volium/swarm/swarm.kicad_pcb

## KiCad design swarm.kicad_pcb (2017-08-13)

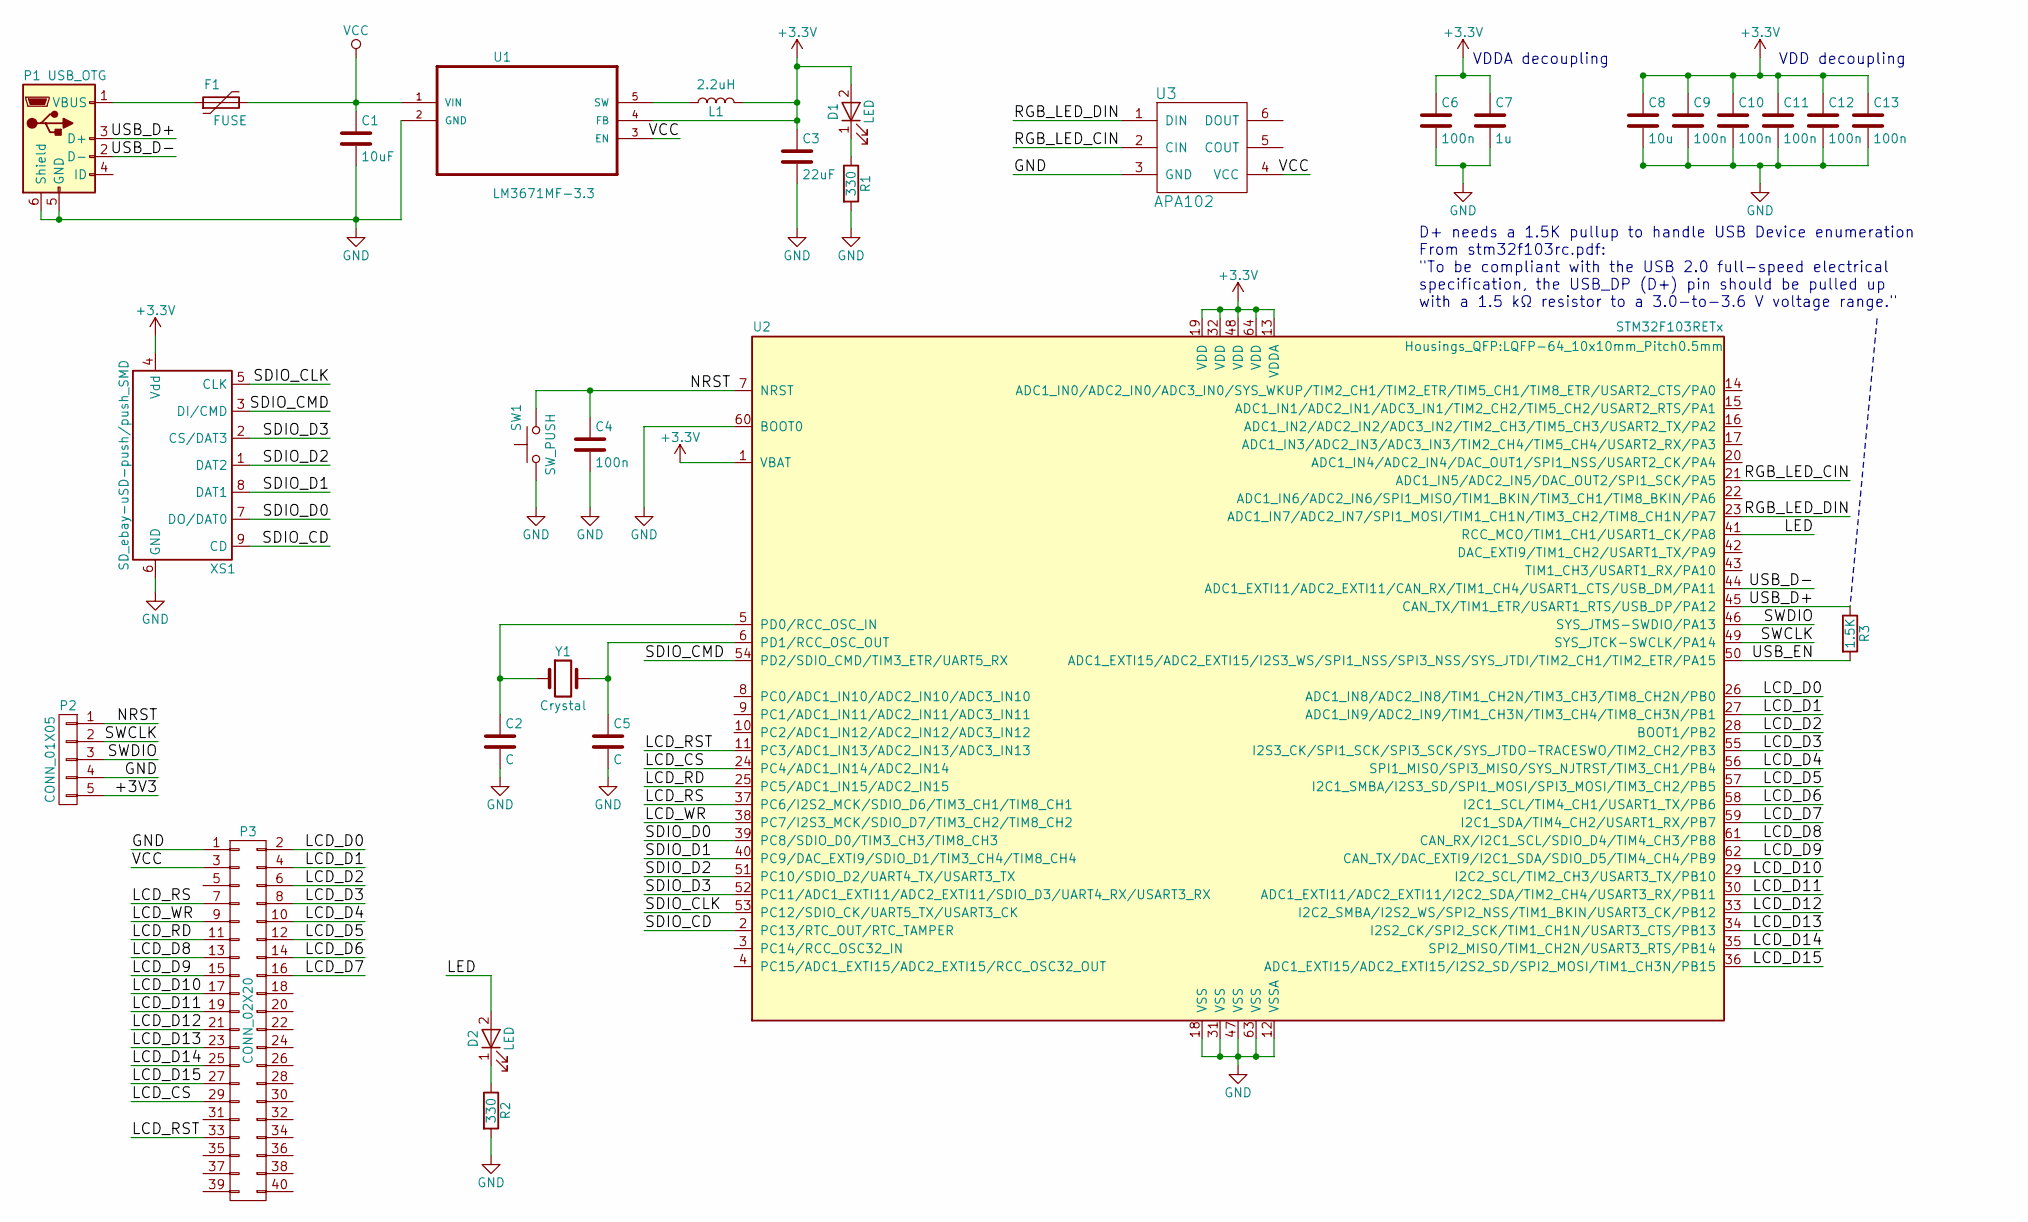
[picture p1: schematic swarm.sch]

Parts:
C1: 10uF; C_0805
C2, C5: C; C_0805
C3: 22uF; C_0805
C4, C6, C9, C10, C11, C12, C13: 100n; C_0805
C7: 1u; C_0805
C8: 10u; C_0805
D1, D2: LED; LED_0805
F1: FUSE; MF-PSMF050X
L1: 2.2uH; Inductor_Taiyo-Yuden_NR-24xx_HandSoldering
P1: USB_OTG; USB_Mini-B
P2: CONN_01X05; Pin_Header_Angled_1x05
P3: CONN_02X20; Pin_Header_Straight_2x20
R1, R2: 330; R_0805
R3: 1.5K; R_0805
SW1: SW_PUSH; SW_SPST_PTS645
U1: LM3671MF-3.3; SOT-23-5
U2: STM32F103RETx; LQFP-64_10x10mm_Pitch0.5mm
U3: APA102
XS1: SD_ebay-uSD-push/push_SMD; Conn_uSDcard
Y1: Crystal; Crystal_SMD_5032_2Pads

Connections:
/LCD_CS: P3.29, U2.24 (PC4/ADC1_IN14/ADC2_IN14)
/LCD_D0: P3.2, U2.26 (ADC1_IN8/ADC2_IN8/TIM1_CH2N/TIM3_CH3/TI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)
/LCD_D1: P3.4, U2.27 (ADC1_IN9/ADC2_IN9/TIM1_CH3N/TIM3_CH4/TI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)
/LCD_D2: P3.6, U2.28 (BOOT1/PB2)
/LCD_D3: P3.8, U2.55 (I2S3_CK/SPI1_SCK/SPI3_SCK/SYS_JTDO-TRAC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)
/LCD_D4: P3.10, U2.56 (SPI1_MISO/SPI3_MISO/SYS_NJTRST/TIM3_CH1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)
/LCD_D5: P3.12, U2.57 (I2C1_SMBA/I2S3_SD/SPI1_MOSI/SPI3_MOSI/T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)
/LCD_D6: P3.14, U2.58 (I2C1_SCL/TIM4_CH1/USART1_TX/PB6)
/LCD_D7: P3.16, U2.59 (I2C1_SDA/TIM4_CH2/USART1_RX/PB7)
/LCD_D8: P3.13, U2.61 (CAN_RX/I2C1_SCL/SDIO_D4/TIM4_CH3/PB8)
/LCD_D9: P3.15, U2.62 (CAN_TX/DAC_EXTI9/I2C1_SDA/SDIO_D5/TIM4_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)
/LCD_D10: P3.17, U2.29 (I2C2_SCL/TIM2_CH3/USART3_TX/PB10)
/LCD_D11: P3.19, U2.30 (ADC1_EXTI11/ADC2_EXTI11/I2C2_SDA/TIM2_C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)
/LCD_D12: P3.21, U2.33 (I2C2_SMBA/I2S2_WS/SPI2_NSS/TIM1_BKIN/US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)
/LCD_D13: P3.23, U2.34 (I2S2_CK/SPI2_SCK/TIM1_CH1N/USART3_CTS/P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)
/LCD_D14: P3.25, U2.35 (SPI2_MISO/TIM1_CH2N/USART3_RTS/PB14)
/LCD_D15: P3.27, U2.36 (ADC1_EXTI15/ADC2_EXTI15/I2S2_SD/SPI2_MO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)
/LCD_RD: P3.11, U2.25 (PC5/ADC1_IN15/ADC2_IN15)
/LCD_RS: P3.7, U2.37 (PC6/I2S2_MCK/SDIO_D6/TIM3_CH1/TIM8_CH1)
/LCD_RST: P3.33, U2.11 (PC3/ADC1_IN13/ADC2_IN13/ADC3_IN13)
/LCD_WR: P3.9, U2.38 (PC7/I2S3_MCK/SDIO_D7/TIM3_CH2/TIM8_CH2)
/LED: D2.2 (A), U2.41 (RCC_MCO/TIM1_CH1/USART1_CK/PA8)
/NRST: C4.1, P2.1, SW1.2, U2.7 (NRST)
/RGB_LED_CIN: U2.21 (ADC1_IN5/ADC2_IN5/DAC_OUT2/SPI1_SCK/PA5), U3.2 (CIN)
/RGB_LED_DIN: U2.23 (ADC1_IN7/ADC2_IN7/SPI1_MOSI/TIM1_CH1N/T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), U3.1 (DIN)
/SDIO_CD: U2.2 (PC13/RTC_OUT/RTC_TAMPER), XS1.9 (CD)
/SDIO_CLK: U2.53 (PC12/SDIO_CK/UART5_TX/USART3_CK), XS1.5 (CLK)
/SDIO_CMD: U2.54 (PD2/SDIO_CMD/TIM3_ETR/UART5_RX), XS1.3 (DI/CMD)
/SDIO_D0: U2.39 (PC8/SDIO_D0/TIM3_CH3/TIM8_CH3), XS1.7 (DO/DAT0)
/SDIO_D1: U2.40 (PC9/DAC_EXTI9/SDIO_D1/TIM3_CH4/TIM8_CH4), XS1.8 (DAT1)
/SDIO_D2: U2.51 (PC10/SDIO_D2/UART4_TX/USART3_TX), XS1.1 (DAT2)
/SDIO_D3: U2.52 (PC11/ADC1_EXTI11/ADC2_EXTI11/SDIO_D3/UA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), XS1.2 (CS/DAT3)
/SWCLK: P2.2, U2.49 (SYS_JTCK-SWCLK/PA14)
/SWDIO: P2.3, U2.46 (SYS_JTMS-SWDIO/PA13)
/USB_D+: P1.3 (D+), R3.1, U2.45 (CAN_TX/TIM1_ETR/USART1_RTS/USB_DP/PA12)
/USB_D-: P1.2 (D-), U2.44 (ADC1_EXTI11/ADC2_EXTI11/CAN_RX/TIM1_CH4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)
/USB_EN: R3.2, U2.50 (ADC1_EXTI15/ADC2_EXTI15/I2S3_WS/SPI1_NS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)
GND: C1.2, C2.2, C3.2, C4.2, C5.2, C6.2, C7.2, C8.2, C9.2, C10.2, C11.2, C12.2, C13.2, P1.5 (GND), P1.6 (Shield), P2.4, P3.1, R1.2, R2.2, SW1.1, U1.2 (GND), U2.12 (VSSA), U2.18 (VSS), U2.31 (VSS), U2.47 (VSS), U2.60 (BOOT0), U2.63 (VSS), U3.3 (GND), XS1.6 (GND)
unnamed: C2.1, U2.5 (PD0/RCC_OSC_IN), Y1.1
unnamed: C5.1, U2.6 (PD1/RCC_OSC_OUT), Y1.2
unnamed: D1.1 (K), R1.1
unnamed: D2.1 (K), R2.1
unnamed: F1.1, P1.1 (VBUS)
unnamed: L1.1, U1.5 (SW)
VCC: C1.1, F1.2, P3.3, U1.1 (VIN), U1.3 (EN), U3.4 (VCC)

Notes on the sheet:
VDDA decoupling
VDD decoupling
D+ needs a 1.5K pullup to handle USB Device enumeration From stm32f103rc.pdf: "To be compliant with the USB 2.0 full-speed electrical specification, the USB_DP (D+) pin should be pulled up with a 1.5 kΩ resistor to a 3.0-to-3.6 V voltage range."

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
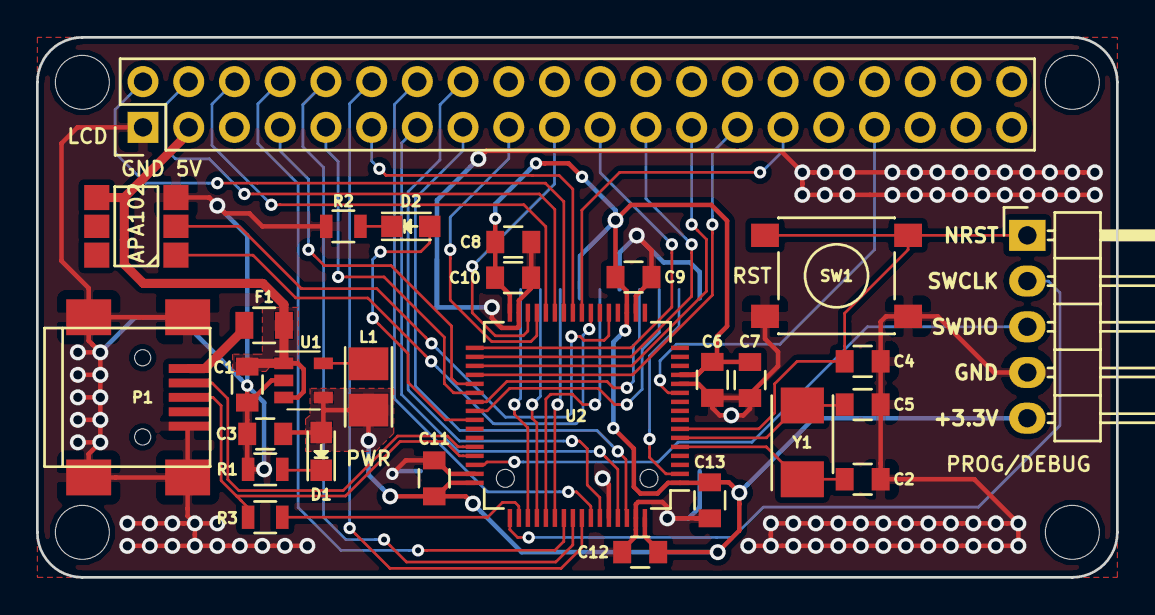
[picture p2: board swarm.kicad_pcb from above]

Board: 2 copper layers, 60.0 x 30.0 mm, 29 parts (0 on the bottom side), 46 nets.
