volium/swarm/(commit log)

2016-10-28 First commit, adds STM32F103RE
    [swarm.kicad_pcb, swarm.sch]
2016-10-30 Adds decouplings capacitors
    [swarm.sch]
2016-12-01 Adds power sypply based on proven LM3671MF-3.3
    [swarm.sch]
2016-12-01 Updates netlist, footprint selection
    [swarm.kicad_pcb, swarm.sch]
2016-12-02 Adds MicroSD card and Mini USB connector via volium KiCad library
    [swarm.kicad_pcb, swarm.sch]
2016-12-03 Adds Micro SD card socket connection
    [swarm.kicad_pcb, swarm.sch]
2016-12-03 Adds LCD connector 2x20 pins
    [swarm.kicad_pcb, swarm.sch]
2016-12-04 Adds Serial Wire Debug connector (5 pins) Sets up PCB layers based on Osh Park's Layer setup
    [swarm.kicad_pcb, swarm.sch]
2016-12-04 Updates to Design Rules and board thicknes based on Osh Park's setup
    [swarm.kicad_pcb]
2016-12-04 Replaces 0603 components with smaller fooprint Regenerated net file and imported in pcbnew
    [swarm.kicad_pcb, swarm.sch]
2016-12-04 Adds APA102 SPI RGB LED Updates schematic references and links docoupling capacitors based on input pin
    [swarm.kicad_pcb, swarm.sch]
2016-12-04 Adds U3 (APA102 LED) to pcbnew
    [swarm.kicad_pcb]
2016-12-06 Moves some components around, no significant changes
    [swarm.kicad_pcb, swarm.sch]
2016-12-07 Moving towards routing Switched to 0805 components Locked connectors and MCU, routed part of LCD_DBXX signals
    [swarm.kicad_pcb, swarm.sch]
2016-12-08 Fixes issue with GND and Vdd swapped for micro SD connector
    [swarm.kicad_pcb, swarm.sch]
2016-12-08 Routed all LCD-related signals
    [swarm.kicad_pcb]
2016-12-08 Connected USB (D+, D-) signals (routable)
    [swarm.kicad_pcb, swarm.sch]
2016-12-08 Routed all LCD signals (not LCD_DB9), and capacitos, only power supply left
    [swarm.kicad_pcb, swarm.sch]
2016-12-08 Routed all LCD signals
    [swarm.kicad_pcb]
2016-12-08 Added SDIO_CD (Card Detect) pin MCU, routed
    [swarm.kicad_pcb, swarm.sch]
2016-12-08 Fully routed, no DRC errors
    [swarm.kicad_pcb, swarm.sch]
2016-12-09 Fixed DRC violations after adding 'Power' net constraints
    [swarm.kicad_pcb]
2016-12-09 Fixed crooked wire
    [swarm.kicad_pcb]
2016-12-09 Sime very important changes Connect LCD_VCC pin to VCC net, this was previously not connected Makes all elements (tracks and vias) in Power net compliant with its constraints
    [swarm.kicad_pcb, swarm.sch]
2016-12-09 Fixes track width
    [swarm.kicad_pcb]
2016-12-09 More cleanup
    [swarm.kicad_pcb]
2016-12-09 Connected missing ground pad, DRC back at 0 errors, added some vias
    [swarm.kicad_pcb]
2016-12-10 Improvements and cleanup Via stitching, moved Debug (P2) connector to the right
    [swarm.kicad_pcb]
2016-12-10 More via stitching
    [swarm.kicad_pcb]
2016-12-10 Swapped physical locations of push button and APA102
    [swarm.kicad_pcb]
2016-12-10 All signals routed, including APA102 CLK, DATA More via cleanup
    [swarm.kicad_pcb]
2016-12-10 Saved after merge, no real changes
    [swarm.kicad_pcb]
2016-12-10 Removes unnecessary track on bottom (NRST)
    [swarm.kicad_pcb]
2016-12-12 Adds fuse (MF-PSMF050X) to schematic and layout
    [swarm.kicad_pcb, swarm.sch]
2016-12-12 Updates footprints, adds via to connect ground to APA102
    [swarm.kicad_pcb]
2016-12-12 Via stitching
    [swarm.kicad_pcb]
2016-12-12 Fixes pinout of debug connector, still needs to reroute
    [swarm.kicad_pcb, swarm.sch]
2016-12-12 More changes Finished routing debug connector Added labels to debug connector pins
    [swarm.kicad_pcb]
2016-12-14 Cleanup Added back 3D model for L1 inductor (lost in a previous commit) More via stitching
    [swarm.kicad_pcb]
2016-12-14 More cleanup Moved some tracks, reran DRC
    [swarm.kicad_pcb]
2016-12-14 Major cleanup Resized references to 0.6 width and height Increased width of VCC track
    [swarm.kicad_pcb]
2016-12-15 Added new copper zone for +3.3V around power supply components
    [swarm.kicad_pcb]
2016-12-19 Adds LED to TIM2_CH1 (pin 50) Added PWR label, cleanup
    [swarm.kicad_pcb, swarm.sch]
2016-12-23 Updates after upgrading to KiCAD 4.0.5 Updated schematic components to new libraries Cleaned up some tracks in layout
    [swarm.kicad_pcb, swarm.sch]
2016-12-23 Minor changes
    [swarm.sch]
2016-12-23 Moved some vias, cleaned up some tracks
    [swarm.kicad_pcb]
2016-12-23 Fixed "no_connects", cleaned up some tracks
    [swarm.kicad_pcb]
2016-12-26 Decreased clearance to 12 mils for GND planes (top and bottom)
    [swarm.kicad_pcb]
2016-12-27 Added copper zone for VCC Cleaned up silk screen layer
    [swarm.kicad_pcb]
2016-12-27 Moved via to fix remaining DRC issue
    [swarm.kicad_pcb]
2016-12-27 Added OSHW logo (silkscreen)
    [swarm.kicad_pcb]
2016-12-27 Recalculated DRC
    [swarm.kicad_pcb]
2016-12-27 Moved via to allow for better copper fill (GND)
    [swarm.kicad_pcb]
2016-12-27 Adds final gerber files
    [swarm-B.Mask.gbs, swarm-B.SilkS.gbo, swarm-Bottom.gbl, swarm-Edge.Cuts.gm1, swarm-F.Mask.gts, swarm-F.SilkS.gto, swarm-Top.gtl, swarm.drl]
2017-01-04 Updates kicad_pcb file after re-running "refill all zones" and "DRC"
    [swarm.kicad_pcb]
2017-01-11 Updates 3D model for LCD P3 (2-row 20-pin) connector I had the wrong model for the P3 connector, it was always supposed to be a socket strip (female) connector, not male pins. Adds grid originin at 1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
    [swarm.kicad_pcb]
2017-01-16 Connects 'BOOT0' pin (60) to ground Forgot to connect this pin in Rev 1.0, this pin need to be '0' to select Boot Mode "Main Flash memory" In layout, connected PIN 60 (BOOT0) to GND using 'via'
    [swarm.kicad_pcb, swarm.sch]
2017-01-16 Re-ran DRC, no_connects back to 0
    [swarm.kicad_pcb]
2017-01-17 Cosmetic change to schematic, regenerated net file
    [swarm.sch]
2017-01-27 Adds USB 1.5K pullup via GPIO Connects 1.5K pullup resistor to D+ of USB, as stated by stm32f103rc.pdf. Connected resistor to PIN PA15 to allow for SW control (USB_EN). Moves LED from pin PA15 to PA8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
    [swarm.kicad_pcb, swarm.sch]
2017-01-27 Reran DRC on PCB, no design changes
    [swarm.kicad_pcb]
2017-01-27 Moves SD card connector (Conn_uSDcard) 0.5 mm up Rerouted all necessary signals around Conn_uSDcard drill holes, redid tracks to Conn_uSDcard pads. Cleaned up some tracks and vias. Reran DRC
    [swarm.kicad_pcb]
2017-07-22 Updates project to KiCad 4.0.6 Replaces USB connector schematic symbol, regenerated netlist, updated PCB file
    [swarm.kicad_pcb, swarm.sch]
2017-07-30 Updates XS1 Conn_uSDcard footprint with updated component in volium library (updated 3D model)
    [swarm.kicad_pcb]
2017-07-30 Updates U3 APA102 footprint with updated component in volium library (updated 3D model)
    [swarm.kicad_pcb]
2017-07-30 Updates 3D Model for P1 (USB Mini-B) and L1 (Inductor)
    Updated footprint of P1, USB_Mini-B, using updated version of volium library (updated 3D model)
    Updated 3D Model for L1, using new NR2412 model in 3DModels repository
    [swarm.kicad_pcb]
2017-08-13 Updates 3D Model for MF-PSMF020X.wrl
    Updates model with new updated version available in Volium 3D models repository (no scaling, shifting, rotation necessary)
    [swarm.kicad_pcb]
